Alex-C-EE/StartStopModule/README.md

# StartStopModule
A repo containing original and custom start stop modules for robo sumo and their firmware. Manufacturing files generated.
