Alex-C-EE/StartStopModule/003Robotics/Modul/Basket_Nov08_0328PM.xls

SHOPPING BASKET
This is not an invoice
08-Nov-25 15:28:43
 | Mouser No | Mfr. No | Manufacturer | Customer No | Description | RoHS | Lifecycle | Order Qty. | Price (EUR) | Ext.: (EUR)
1 | 187-CL05B104KB54PNC | CL05B104KB54PNC | Samsung Electro-Mechanics |  | Multilayer Ceramic Capacitors MLCC - SMD/SMT 0.1uF 50VX7R 1005 AE 0402 | RoHS Compliant |  | 2 | 0,095 € | 0,19 €
2 | 187-CL05A105KA5NQNC | CL05A105KA5NQNC | Samsung Electro-Mechanics |  | Multilayer Ceramic Capacitors MLCC - SMD/SMT 1uF+/-10% 25V X5R 10 0402 | RoHS Compliant |  | 2 | 0,086 € | 0,17 €
3 | 78-TSOP39438TR1 | TSOP39438TR1 | Vishay |  | Infrared Receivers 38 kHz AGC5 TVCast | RoHS Compliant |  | 1 | 0,731 € | 0,73 €
4 | 511-STM32C011F4U6TR | STM32C011F4U6TR | STMicroelectronics |  | ARM Microcontrollers - MCU Arm Cortex-M0+ MCU with 16 Kbytes of Flash memory, 6 Kbytes RAM, 48 MHz | RoHS Compliant |  | 1 | 0,697 € | 0,70 €
5 | 771-PESD3V3L1BSLZ | PESD3V3L1BSLZ | Nexperia |  | ESD Protection Diodes / TVS Diodes ESD 3.3V BI | RoHS Compliant |  | 2 | 0,086 € | 0,17 €
6 | 757-1SS389L3F | 1SS389,L3F | Toshiba |  | Schottky Diodes & Rectifiers Sml-Signal Schottky Barrier Diode | RoHS Compliant |  | 1 | 0,12 € | 0,12 €
7 | 511-LDK220PU33R | LDK220PU33R | STMicroelectronics |  | LDO Voltage Regulators 200 mA low quiescent current and low noise LDO | RoHS Compliant |  | 1 | 0,335 € | 0,34 €
8 | 859-LTST-C190GKT | LTST-C190GKT | LITEON |  | Single Colour LEDs Green Clear 569nm | RoHS Compliant |  | 1 | 0,103 € | 0,10 €
9 | 791-MR04X1001FTL | MR04X1001FTL | Walsin |  | Thick Film Resistors - SMD 1 kOhms 50 V 100 mW 1 % 0402 100 PPM / C AEC-Q200 | RoHS Compliant |  | 1 | 0,108 € | 0,11 €
10 | 576-0603L025YR | 0603L025YR | Littelfuse |  | Resettable Fuses - PPTC PTC 9V .250A POLY SURF MOUNT | RoHS Compliant |  | 1 | 0,955 € | 0,96 €
By submitting your order you agree to these terms and conditions. (https://eu.mouser.com/saleterms) |  |  |  |  |  |  |  |  | Merchandise: | 3,59 €
Prices are reflected at the date and time shown. |  |  |  |  |  |  |  |  | Delivery Charge: | 20,00 €
