Alex-C-EE/StartStopModule/003Robotics/Modul/003RoboticsStartStop/003RoboticsStartStop.kicad_pcb

## KiCad design 003Robotics/Modul/003RoboticsStartStop/003RoboticsStartStop.kicad_pcb (2025-12-12)

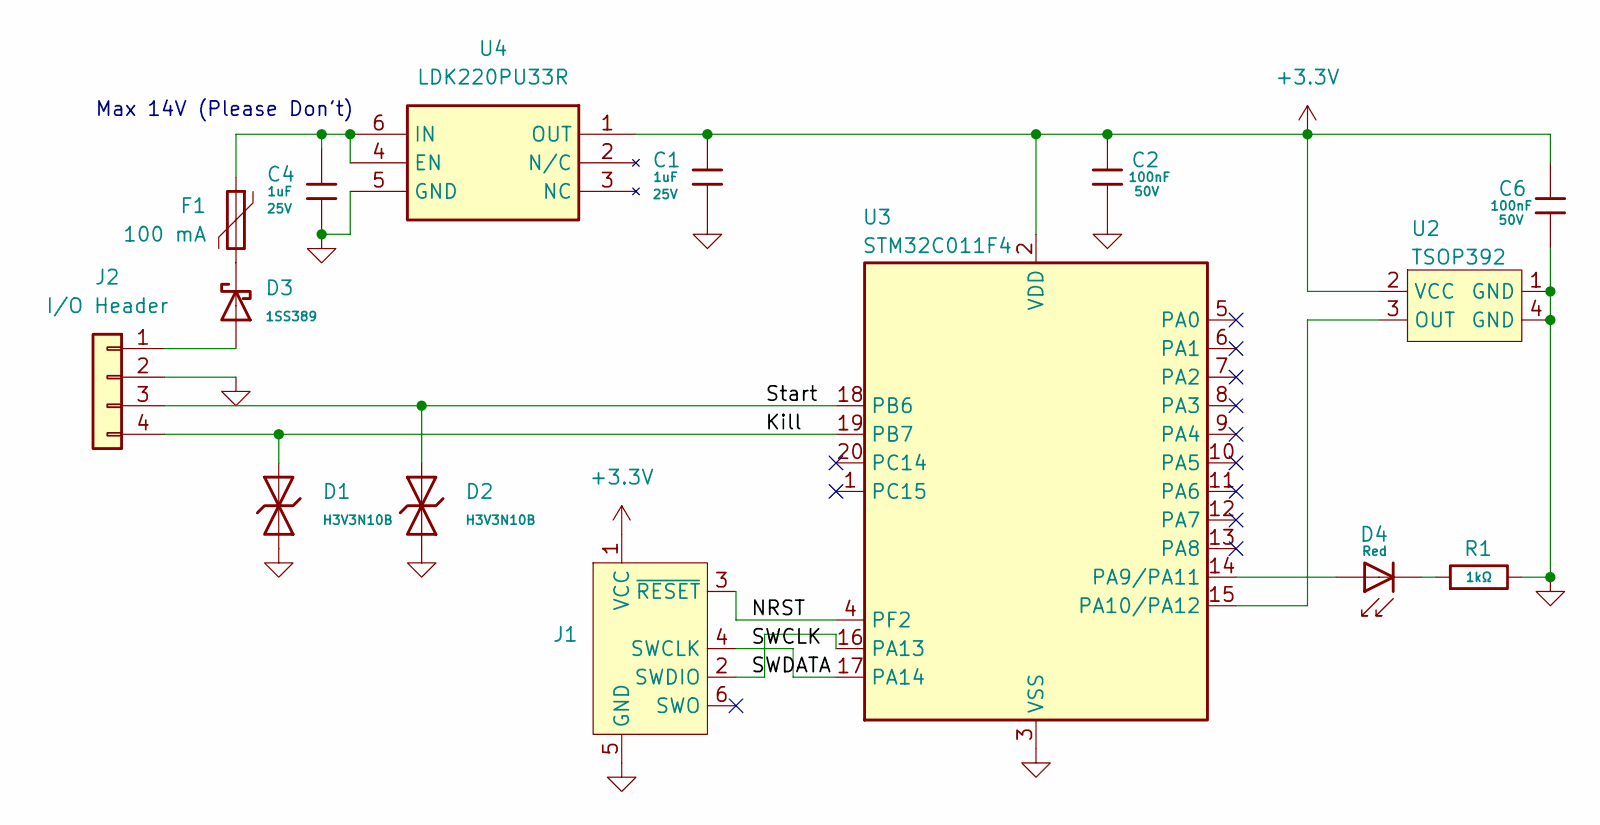
[picture p3: schematic 003RoboticsStartStop.kicad_sch]

Parts:
C1, C4: 1uF; C_0402; Voltage Rated 25V; Tolerance ±10%; Part CL05A105KA5NQNC; LCSC C52923
C2, C6: 100nF; C_0402; Voltage Rated 50V; Tolerance ±10%; Part CL05B104KB54PNC; LCSC C307331
D1, D2: H3V3N10B; D_DFN1006-2L; Part H3V3N10B; LCSC C20617909
D3: 1SS389; D_SOD-523; Part 1SS389; LCSC C22466369
D4: Red; D_0603; Part KT-0603R; LCSC C2286
F1: 100 mA; Fuse_0603_1608Metric
J1: Conn_ARM_SWD_TagConnect_TC2030-NL; Tag-Connect_TC2030-IDC-NL_2x03_P1.27mm_Vertical
J2: I/O Header; PinHeader_1x04_P2.54mm_Vertical
R1: 1kΩ; R_0402; Overload Voltage (Max) 50V; Tolerance ±1%; Part 0402WGF1001TCE; LCSC C11702
U2: TSOP392; TVCastSMD4
U3: STM32C011F4; ST_UFQFPN-20_3x3mm_P0.5mm
U4: LDK220PU33R; Mouser Part Number 511-LDK220PU33R

Connections:
+3.3V: C1.1, C2.1, C6.1, J1.1 (VCC), U2.2 (VCC), U3.2 (VDD), U4.1 (OUT)
/Kill: D1.2, J2.4, U3.19 (PB7)
/NRST: J1.3 (~RESET), U3.4 (PF2)
/SWCLK: J1.4 (SWCLK), U3.17 (PA14)
/SWDATA: J1.2 (SWDIO), U3.16 (PA13)
/Start: D2.2, J2.3, U3.18 (PB6)
GND: C1.2, C2.2, C4.2, C6.2, D1.1, D2.1, J1.5 (GND), J2.2, R1.2, U2.1 (GND), U2.4 (GND), U3.3 (VSS), U4.5 (GND)
unnamed: D3.1, F1.2
unnamed: D4.1, R1.1
unnamed: D3.2, J2.1
unnamed: U2.3 (OUT), U3.15 (PA10/PA12)
unnamed: D4.2, U3.14 (PA9/PA11)
unnamed: C4.1, F1.1, U4.4 (EN), U4.6 (IN)

Notes on the sheet:
Max 14V (Please Don't)

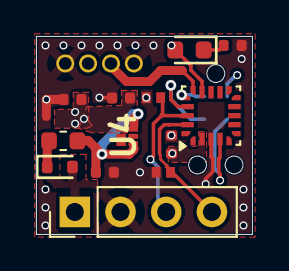
[picture p4: board 003RoboticsStartStop.kicad_pcb from above]

Board: 4 copper layers, 12.0 x 11.0 mm, 15 parts (1 on the bottom side), 13 nets.
