Alex-C-EE/StartStopModule/003Robotics/Modul/003RoboticsStartStop - Dev/003RoboticsStartStop - Dev.kicad_pcb

## KiCad design 003Robotics/Modul/003RoboticsStartStop - Dev/003RoboticsStartStop - Dev.kicad_pcb (2025-11-10)

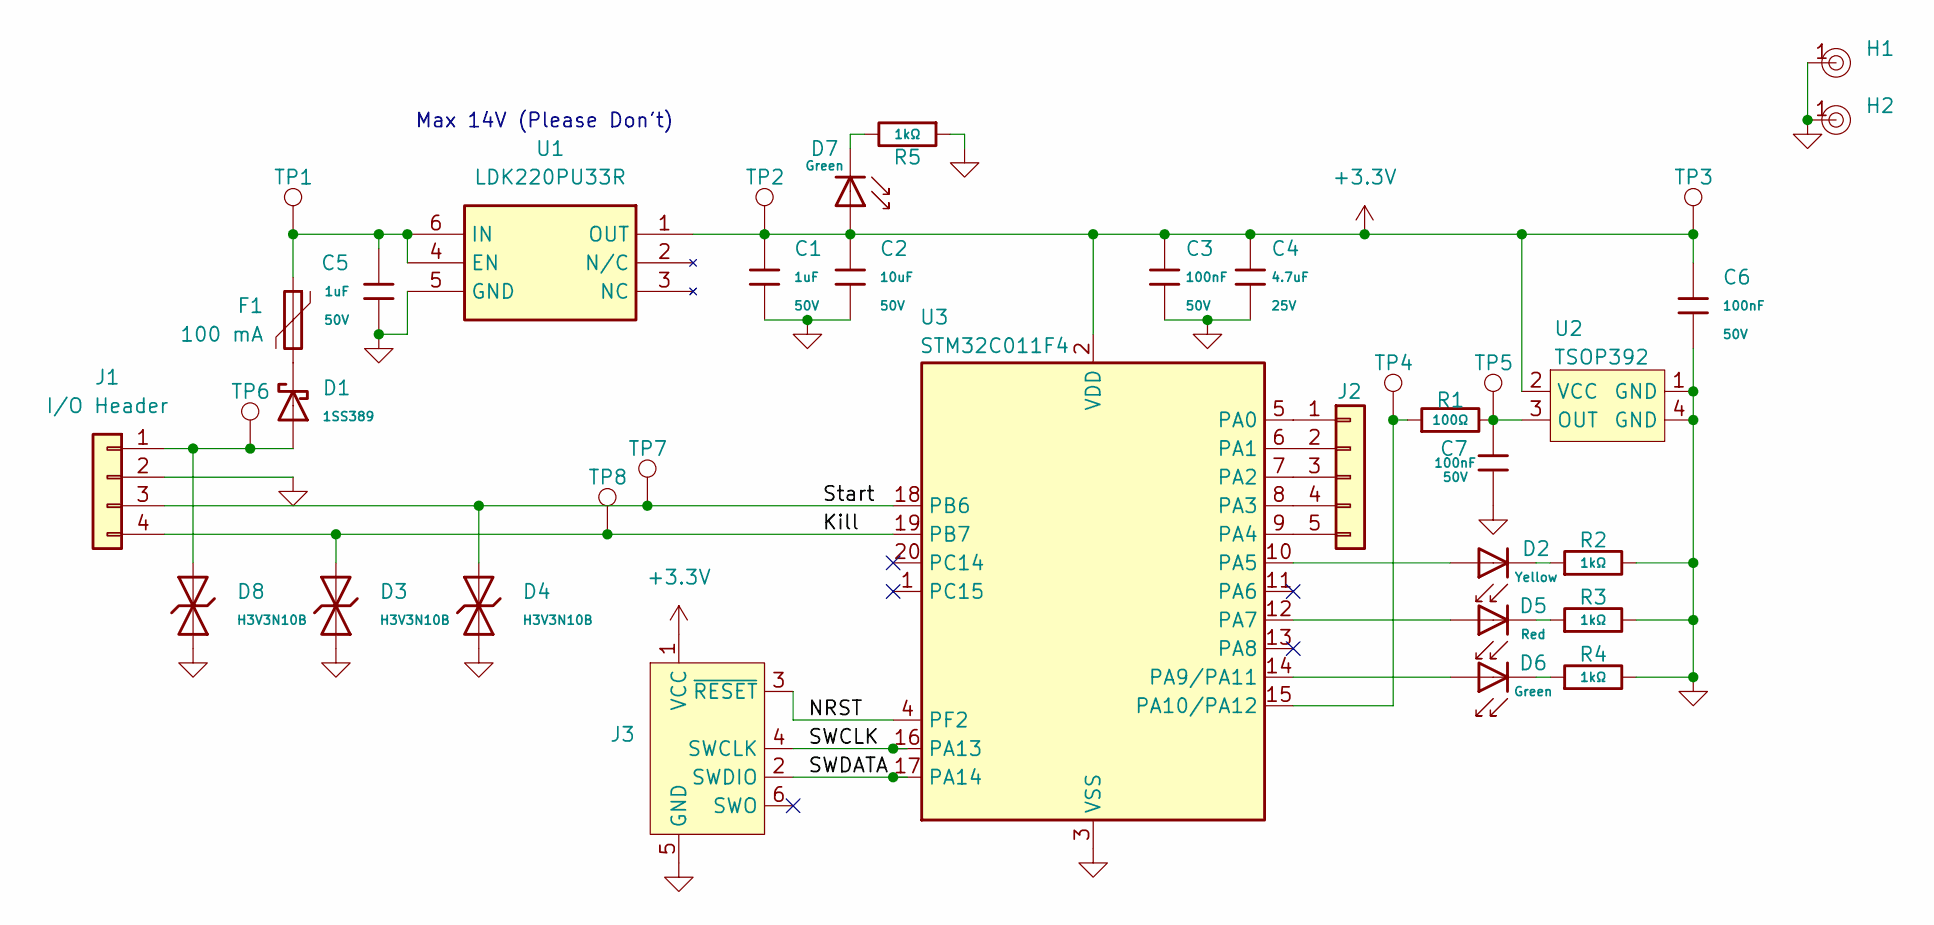
[picture p5: schematic 003RoboticsStartStop - Dev.kicad_sch]

Parts:
C1, C5: 1uF; C_0805; Voltage Rated 50V; Tolerance ±10%; Part CL21B105KBFNNNE; LCSC C28323
C2: 10uF; C_0805; Voltage Rated 50V; Tolerance ±10%; Part GRM21BR61H106KE43L; LCSC C440198
C3, C6, C7: 100nF; C_0805; Voltage Rated 50V; Tolerance ±10%; Part CC0805KRX7R9BB104; LCSC C49678
C4: 4.7uF; C_0805; Voltage Rated 25V; Tolerance ±10%; Part CL21A475KAQNNNE; LCSC C1779
D1: 1SS389; D_SOD-523; Part 1SS389; LCSC C22466369
D2: Yellow; D_0805; Part KT-0805Y; LCSC C2296
D3, D4, D8: H3V3N10B; D_DFN1006-2L; Part H3V3N10B; LCSC C20617909
D5: Red; D_0805; Forward Voltage (VF) 1.6V~2.6V; Part NCD0805R1; LCSC C84256
D6, D7: Green; D_0805; Part KT-0805G; LCSC C2297
F1: 100 mA; Fuse_0603_1608Metric
H1, H2: Hole, 3mm
J1: I/O Header; PinHeader_1x04_P2.54mm_Vertical
J2: Conn_01x05; PinHeader_1x05_P2.54mm_Vertical
J3: Conn_ARM_SWD_TagConnect_TC2030-NL; Tag-Connect_TC2030-IDC-NL_2x03_P1.27mm_Vertical
R1: 100Ω; R_0805; Overload Voltage (Max) 150V; Tolerance ±1%; Part 0805W8F1000T5E; LCSC C17408
R2, R3, R4, R5: 1kΩ; R_0805; Overload Voltage (Max) 150V; Tolerance ±1%; Part 0805W8F1001T5E; LCSC C17513
TP1, TP2, TP3, TP4, TP5, TP6, TP7, TP8: TestPoint; PinHeader_1x01_P1.27mm_Vertical
U1: LDK220PU33R; Mouser Part Number 511-LDK220PU33R
U2: TSOP392; TVCastSMD4
U3: STM32C011F4; ST_UFQFPN-20_3x3mm_P0.5mm

Connections:
+3.3V: C1.1, C2.1, C3.1, C4.1, C6.1, D7.2, J3.1 (VCC), TP2.1, TP3.1, U1.1 (OUT), U2.2 (VCC), U3.2 (VDD)
/Kill: D3.2, J1.4, TP8.1, U3.19 (PB7)
/NRST: J3.3 (~RESET), U3.4 (PF2)
/SWCLK: J3.4 (SWCLK), U3.16 (PA13)
/SWDATA: J3.2 (SWDIO), U3.17 (PA14)
/Start: D4.2, J1.3, TP7.1, U3.18 (PB6)
GND: C1.2, C2.2, C3.2, C4.2, C5.2, C6.2, C7.2, D3.1, D4.1, D8.1, H1.1, H2.1, J1.2, J3.5 (GND), R2.2, R3.2, R4.2, R5.1, U1.5 (GND), U2.1 (GND), U2.4 (GND), U3.3 (VSS)
unnamed: D1.1, F1.2
unnamed: D2.1, R2.1
unnamed: D5.1, R3.1
unnamed: D6.1, R4.1
unnamed: D7.1, R5.2
unnamed: D1.2, D8.2, J1.1, TP6.1
unnamed: J2.1, U3.5 (PA0)
unnamed: J2.2, U3.6 (PA1)
unnamed: J2.3, U3.7 (PA2)
unnamed: J2.4, U3.8 (PA3)
unnamed: J2.5, U3.9 (PA4)
unnamed: C5.1, F1.1, TP1.1, U1.4 (EN), U1.6 (IN)
unnamed: C7.1, R1.2, TP5.1, U2.3 (OUT)
unnamed: D2.2, U3.10 (PA5)
unnamed: D5.2, U3.12 (PA7)
unnamed: D6.2, U3.14 (PA9/PA11)
unnamed: R1.1, TP4.1, U3.15 (PA10/PA12)

Notes on the sheet:
Max 14V (Please Don't)

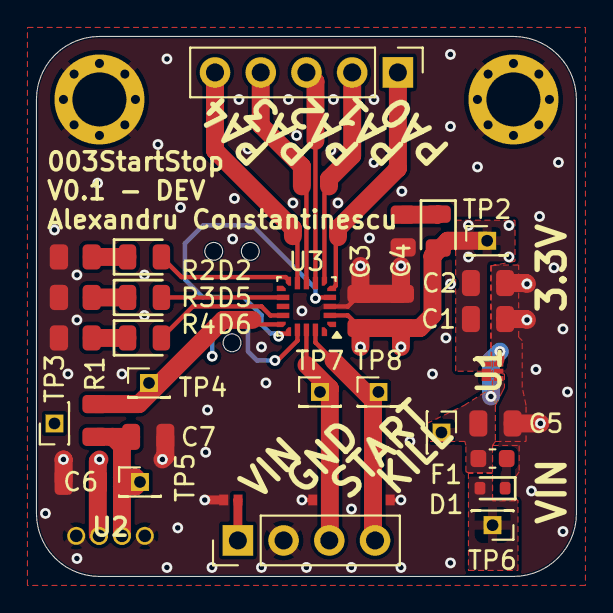
[picture p6: board 003RoboticsStartStop - Dev.kicad_pcb from above]

Board: 4 copper layers, 30.0 x 30.0 mm, 37 parts (1 on the bottom side), 24 nets.
