Alex-C-EE/StartStopModule/Original P1R.SE/Hardware/Remote_Control/Version_0.04/remote_V0_04_.brd

## EAGLE design Original P1R.SE/Hardware/Remote_Control/Version_0.04/remote_V0_04_.brd (2025-11-10)

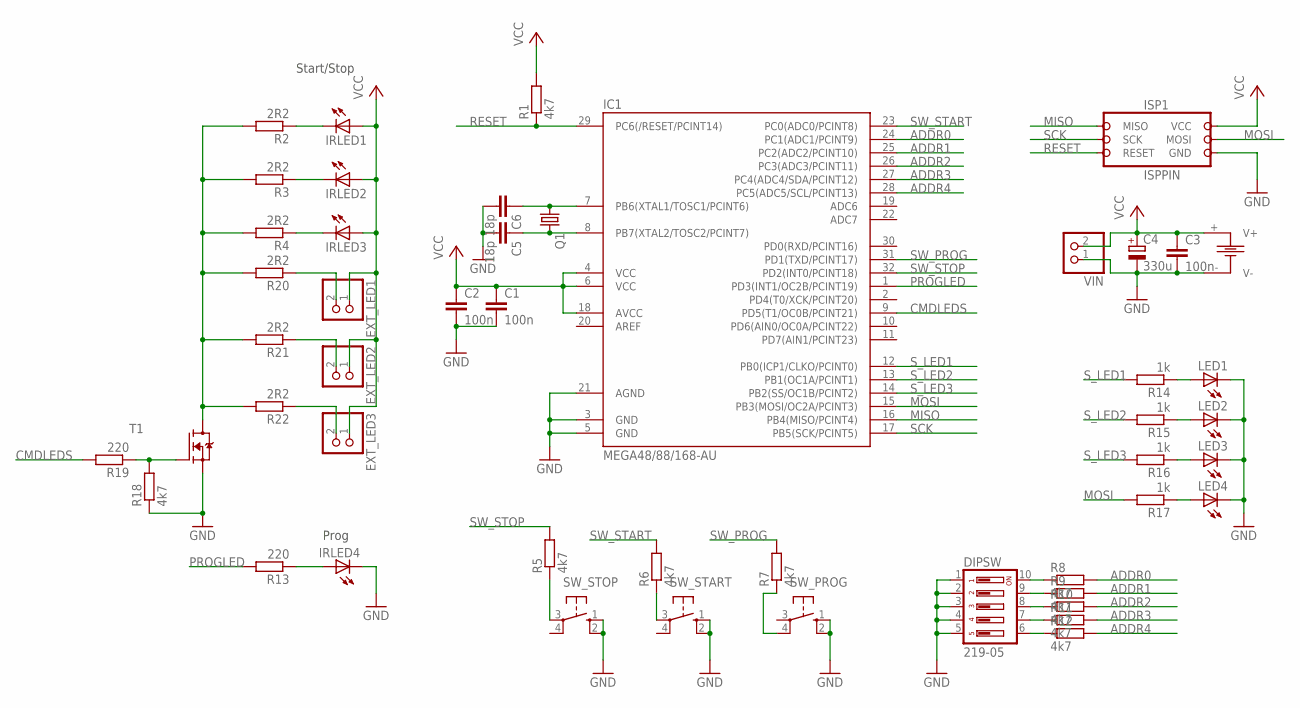
[picture p10: schematic remote_V0_04_.sch]

Parts:
B1: BATTERY_HOLDER_1; BAT_HOLDER_1
C1, C2, C3: 100n; C0805WP
C4: 330u; SANYO-OSCON_SMD_C6
C5, C6: 18p; C0805WP
DIPSW: 219-05; CTS-219-05
EXT_LED1, EXT_LED2, EXT_LED3: PINHD-1X2LONG; 1X2LONG
IC1: MEGA48/88/168-AU; TQFP32-08
IRLED1, IRLED2, IRLED3, IRLED4: LEDLED5MMH; LED5MMH
ISP1: ISPPIN; 2X03
LED1, LED2, LED3, LED4: LED0805; LED_0805
Q1: CRYSTALHC49S; HC49/S
R1, R5, R6, R7, R8, R9, R10, R11, R12, R18: 4k7; R0805WP
R2, R3, R4, R20, R21, R22: 2R2; R0805WP
R13, R19: 220; R0805WP
R14, R15, R16, R17: 1k; R0805WP
SW_PROG: 10-XX; B3F-10XX
SW_START: 10-XX; B3F-10XX
SW_STOP: 10-XX; B3F-10XX
T1: MOSFET_N_SOT23; SOT23
VIN: PINHD-1X2; 1X02

Connections:
ADDR0: IC1.24 (PC1(ADC1/PCINT9)), R8.2
ADDR1: IC1.25 (PC2(ADC2/PCINT10)), R9.2
ADDR2: IC1.26 (PC3(ADC3/PCINT11)), R10.2
ADDR3: IC1.27 (PC4(ADC4/SDA/PCINT12)), R11.2
ADDR4: IC1.28 (PC5(ADC5/SCL/PCINT13)), R12.2
CMDLEDS: IC1.9 (PD5(T1/OC0B/PCINT21)), R19.2
GND: B1.- (V-), C1.2, C2.2, C3.2, C4.-, C5.2, C6.2, DIPSW.1, DIPSW.2, DIPSW.3, DIPSW.4, DIPSW.5, IC1.3 (GND), IC1.5 (GND), IC1.21 (AGND), IRLED4.P$2 (C), ISP1.6 (GND), LED1.C, LED2.C, LED3.C, LED4.C, R18.1, SW_PROG.1 (S), SW_PROG.2 (S1), SW_START.1 (S), SW_START.2 (S1), SW_STOP.1 (S), SW_STOP.2 (S1), T1.2 (S), VIN.1
MISO: IC1.16 (PB4(MISO/PCINT4)), ISP1.1 (MISO)
MOSI: IC1.15 (PB3(MOSI/OC2A/PCINT3)), ISP1.4 (MOSI), R17.2
unnamed: IRLED1.P$2 (C), R2.1
unnamed: IRLED2.P$2 (C), R3.1
unnamed: IRLED3.P$2 (C), R4.1
unnamed: DIPSW.10, R8.1
unnamed: DIPSW.9, R9.1
unnamed: DIPSW.8, R10.1
unnamed: DIPSW.7, R11.1
unnamed: DIPSW.6, R12.1
unnamed: R5.1, SW_STOP.3
unnamed: R6.1, SW_START.3
unnamed: R7.1, SW_PROG.4 (P1)
unnamed: IRLED4.P$1 (A), R13.1
unnamed: R18.2, R19.1, T1.1 (G)
unnamed: LED1.A, R14.1
unnamed: LED2.A, R15.1
unnamed: LED3.A, R16.1
unnamed: LED4.A, R17.1
unnamed: C6.1, IC1.7 (PB6(XTAL1/TOSC1/PCINT6)), Q1.1
unnamed: EXT_LED1.2, R20.1
unnamed: EXT_LED2.2, R21.1
unnamed: R2.2, R3.2, R4.2, R20.2, R21.2, R22.2, T1.3 (D)
unnamed: EXT_LED3.2, R22.1
unnamed: C5.1, IC1.8 (PB7(XTAL2/TOSC2/PCINT7)), Q1.2
PROGLED: IC1.1 (PD3(INT1/OC2B/PCINT19)), R13.2
RESET: IC1.29 (PC6(/RESET/PCINT14)), ISP1.5 (RESET), R1.1
SCK: IC1.17 (PB5(SCK/PCINT5)), ISP1.3 (SCK)
SW_PROG: IC1.31 (PD1(TXD/PCINT17)), R7.2
SW_START: IC1.23 (PC0(ADC0/PCINT8)), R6.2
SW_STOP: IC1.32 (PD2(INT0/PCINT18)), R5.2
S_LED1: IC1.12 (PB0(ICP1/CLKO/PCINT0)), R14.2
S_LED2: IC1.13 (PB1(OC1A/PCINT1)), R15.2
S_LED3: IC1.14 (PB2(SS/OC1B/PCINT2)), R16.2
VCC: B1.+ (V+), C1.1, C2.1, C3.1, C4.+, EXT_LED1.1, EXT_LED2.1, EXT_LED3.1, IC1.4 (VCC), IC1.6 (VCC), IC1.18 (AVCC), IRLED1.P$1 (A), IRLED2.P$1 (A), IRLED3.P$1 (A), ISP1.2 (VCC), R1.2, VIN.2

Notes on the sheet:
Start/Stop
Prog

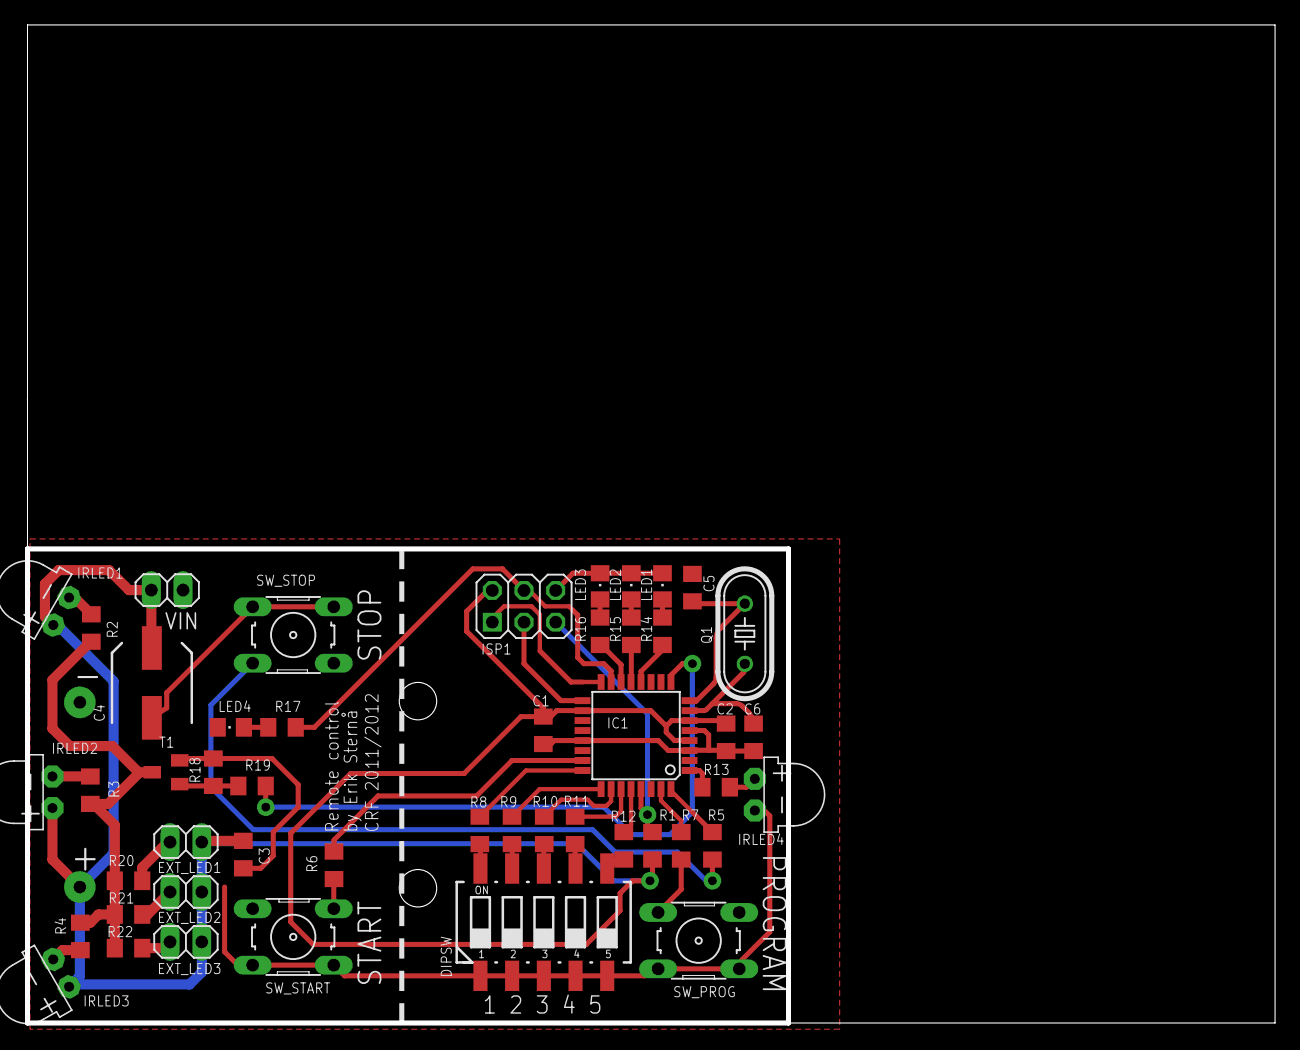
[picture p11: board remote_V0_04_.brd from above]

Board: 2 copper layers, 100.0 x 80.0 mm, 49 parts (1 on the bottom side), 42 nets.
