Alex-C-EE/StartStopModule/003Robotics/Modul/Software/Core/Src/main.c

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
/* Includes ------------------------------------------------------------------*/
#include "main.h"
#include "start.h"
/* USER CODE BEGIN PM */
#define LED_ON()			(HAL_GPIO_WritePin(OUT_StatusLED_GPIO_Port, OUT_StatusLED_Pin, GPIO_PIN_SET))
#define LED_OFF()			(HAL_GPIO_WritePin(OUT_StatusLED_GPIO_Port, OUT_StatusLED_Pin, GPIO_PIN_RESET))
#define LED_TOGGLE()		(HAL_GPIO_TogglePin(OUT_StatusLED_GPIO_Port, OUT_StatusLED_Pin))
/* USER CODE END PM */


TIM_HandleTypeDef htim1;

void SystemClock_Config(void);
static void MX_GPIO_Init(void);
static void MX_TIM1_Init(void);
/* USER CODE BEGIN PFP */
void start_save_data(START_DATA *data);
void start_load_data(START_DATA *data);
void start_state_changed(char new_state);
void start_programming_done(char new_stop_cmd);
void delay_no_timer(void); // Simple blocking delay
/* USER CODE END PFP */

/**
  * @brief  The application entry point.
  * @retval int
  */
int main(void)
{

  /* MCU Configuration--------------------------------------------------------*/

  /* Reset of all peripherals, Initializes the Flash interface and the Systick. */
  HAL_Init();

  /* Configure the system clock */
  SystemClock_Config();

  /* Initialize all configured peripherals */
  MX_GPIO_Init();
  MX_TIM1_Init();
  /* USER CODE BEGIN 2 */
  start_init(start_save_data,
             start_load_data,
             start_programming_done,
             start_state_changed);
  /* USER CODE END 2 */

  /* Infinite loop */
  /* USER CODE BEGIN WHILE */
  while (1)
  {
    /* USER CODE END WHILE */

    /* USER CODE BEGIN 3 */
	// Non-blocking flash for the final STOPPED state
	if (start_get_state() == START_STATE_STOPPED)
	{
	    LED_ON();
	    HAL_Delay(50); // Use HAL_Delay, it's safe in the main loop
	    LED_OFF();
	    HAL_Delay(50);
	}
  }
  /* USER CODE END 3 */
}

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
/* USER CODE BEGIN 4 */
/**
 * @brief  Delay function that does not use SysTick.
 * Used for simple blocking delays in indication functions.
 * Calibrated for 48MHz clock.
 */
void delay_no_timer(void) {
	volatile uint32_t delay = 480000; // Approx 100ms
	while(delay--) {
		__NOP();
	}

	// --- Start Module Callback Implementations ---

	/**
	 * @brief  Save start data to non-volatile memory.
	 * @note   STM32C0 has no EEPROM. You must implement Flash Emulated EEPROM here
	 * to properly save the `stop_cmd` across power cycles.
	 */
	void start_save_data(START_DATA *data) {
		/*
		 * TODO: Implement saving `data->stop_cmd` and `data->state` to Flash memory.
		 */
	    (void)data; // Suppress unused parameter warning
	}

	/**
	 * @brief  Load start data from non-volatile memory.
	 * @note   See `start_save_data`. This function should read from Flash.
	 */
	void start_load_data(START_DATA *data) {
		/*
		 * TODO: Implement loading from Flash memory.
		 *
		 * If read fails or data is invalid:
		 * data->state = START_STATE_POWER_ON;
		 * data->stop_cmd = START_DEFAULT_STOP_CMD;
		 */

	    // For now, just set defaults
		data->state = START_STATE_POWER_ON;
		data->stop_cmd = START_DEFAULT_STOP_CMD;
	}

	/**
	 * @brief  Called when the start module state changes.
	 * This is where we control the robot's output pins.
	 */
	void start_state_changed(char new_state) {
		switch(new_state) {
		case START_STATE_POWER_ON:
			LED_OFF();
			HAL_GPIO_WritePin(OUT_Start_GPIO_Port, OUT_Start_Pin, GPIO_PIN_RESET);
			HAL_GPIO_WritePin(OUT_Kill_GPIO_Port, OUT_Kill_Pin, GPIO_PIN_RESET);
			break;

		case START_STATE_STARTED:
			LED_ON();
			HAL_GPIO_WritePin(OUT_Start_GPIO_Port, OUT_Start_Pin, GPIO_PIN_SET);
			HAL_GPIO_WritePin(OUT_Kill_GPIO_Port, OUT_Kill_Pin, GPIO_PIN_RESET);
			break;

		case START_STATE_STOPPED_SAFE:
			LED_TOGGLE(); // Start flashing
			HAL_GPIO_WritePin(OUT_Start_GPIO_Port, OUT_Start_Pin, GPIO_PIN_RESET);
			HAL_GPIO_WritePin(OUT_Kill_GPIO_Port, OUT_Kill_Pin, GPIO_PIN_SET); // Set Kill pin
			break;

		case START_STATE_STOPPED:
			LED_OFF(); // LED will be flashed by main loop
			HAL_GPIO_WritePin(OUT_Start_GPIO_Port, OUT_Start_Pin, GPIO_PIN_RESET);
			HAL_GPIO_WritePin(OUT_Kill_GPIO_Port, OUT_Kill_Pin, GPIO_PIN_SET);
			// Main loop `while(1)` will now take over flashing the LED
			break;
		}
	}

	/**
	 * @brief  Called when a new STOP command is successfully programmed.
	 * Indicate this to the user (e.g., flash LED).
	 */
	void start_programming_done(char new_stop_cmd) {
		(void)new_stop_cmd; // Suppress warning

		// Flash LED twice quickly
		LED_OFF();
		delay_no_timer();
		LED_ON();
		delay_no_timer();
		LED_OFF();
		delay_no_timer();
		LED_ON();
		delay_no_timer();
		LED_OFF();
	}


	// --- HAL Interrupt Callback Implementations ---

	/**
	 * @brief  External Line Interrupts
	 * @param  GPIO_Pin: The pin that triggered the interrupt
	 */
	void HAL_GPIO_EXTI_Callback(uint16_t GPIO_Pin)
	{
	  if (GPIO_Pin == IN_IR_Pin)
	  {
	    // Call the ported IR state machine from ir_rc5.c
	    process_ir_pin_interrupt();
	  }
	}

	/**
	  * @brief  Timer Period Elapsed Callback
	  * @param  htim: timer handle
	  */
	void HAL_TIM_PeriodElapsedCallback(TIM_HandleTypeDef *htim)
	{
	  if (htim->Instance == TIM1)
	  {
	    // Call the ported IR timer timeout function from ir_rc5.c
	    process_ir_timer_timeout();
	  }
	}
/* USER CODE END 4 */
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
