Alex-C-EE/StartStopModule/003Robotics/Modul/Software/Core/Inc/main.h

#define OUT_StatusLED_Pin GPIO_PIN_11
#define OUT_StatusLED_GPIO_Port GPIOA
#define IN_IR_Pin GPIO_PIN_12
#define IN_IR_GPIO_Port GPIOA
#define IN_IR_EXTI_IRQn EXTI4_15_IRQn
#define OUT_Start_Pin GPIO_PIN_6
#define OUT_Start_GPIO_Port GPIOB
#define OUT_Kill_Pin GPIO_PIN_7
#define OUT_Kill_GPIO_Port GPIOB
