Alex-C-EE/StartStopModule/(commit log)

2025-11-10 Start Good
    [003RoboticsRemote.kicad_pcb, 003RoboticsRemote.kicad_sch, 003RoboticsStartStop - Dev.kicad_pcb, 003RoboticsStartStop - Dev.kicad_pcb_bom.csv, 003RoboticsStartStop - Dev.kicad_pcb_positions.csv, 003RoboticsStartStop - Dev.kicad_sch, 003RoboticsStartStop.kicad_pcb, 003RoboticsStartStop.kicad_pcb_bom.csv]
2025-12-12 Inverted SWDIO/SWCLK to correct pins.
    [003RoboticsStartStop.kicad_pcb, 003RoboticsStartStop.kicad_sch]
